SuperQuentin/TheMagicKeys/pictures/pedals.jpg

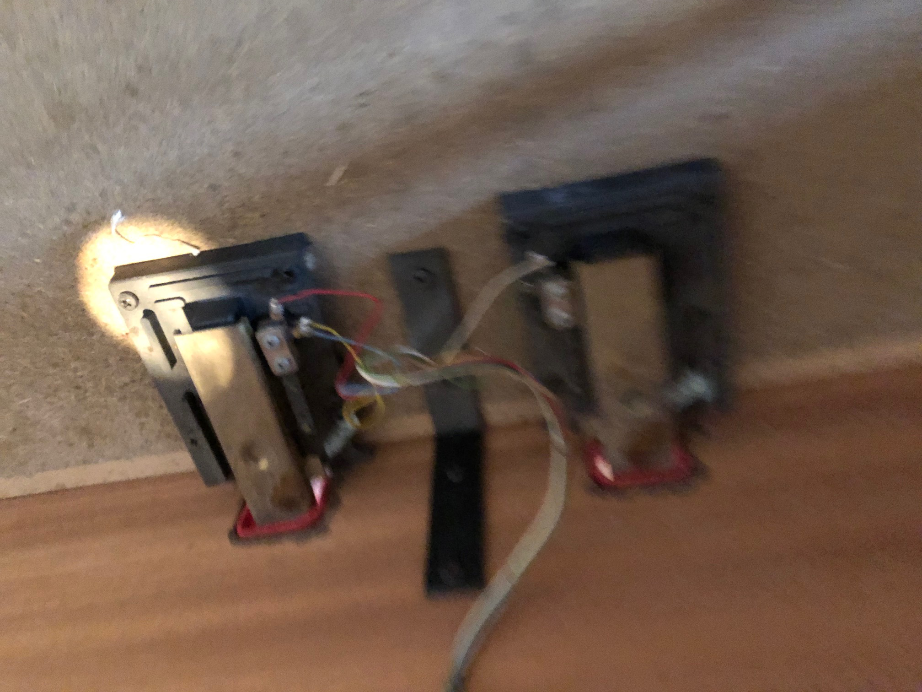
pictures/pedals.jpg
