SuperQuentin/TheMagicKeys/pictures/audio_amplifier_board.jpg

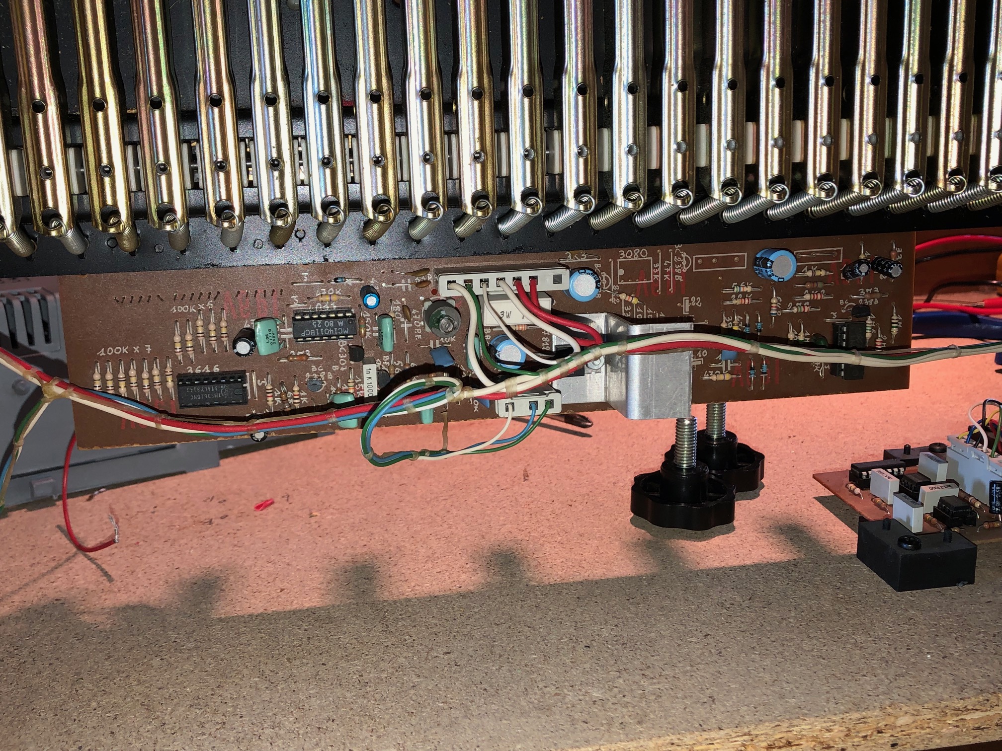
pictures/audio_amplifier_board.jpg
