SuperQuentin/TheMagicKeys/daisy_seed/key_controlled_ocillators/README.md

# key_controlled_ocillators

## Author

<!-- Insert Your Name Here -->

## Description

<!-- Describe your example here -->
