SuperQuentin/TheMagicKeys/pictures/buttons_under_keyboard_1.jpg

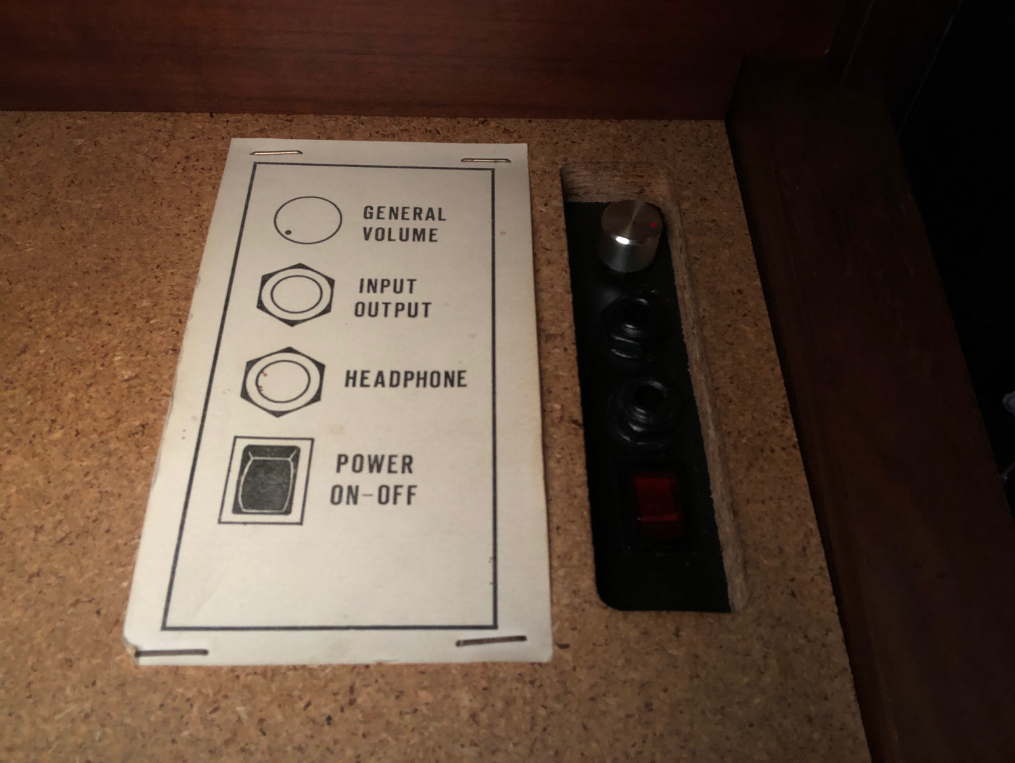
pictures/buttons_under_keyboard_1.jpg
