SuperQuentin/TheMagicKeys/pictures/buttons_under_keyboard_2.jpg

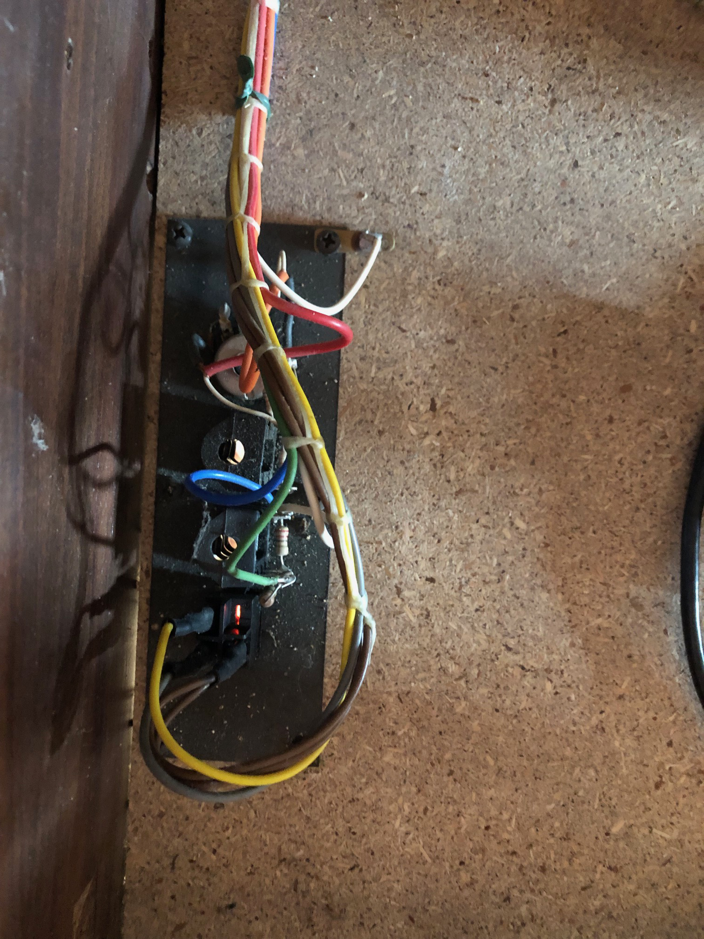
pictures/buttons_under_keyboard_2.jpg
