SuperQuentin/TheMagicKeys/pictures/load_speaker_3.jpg

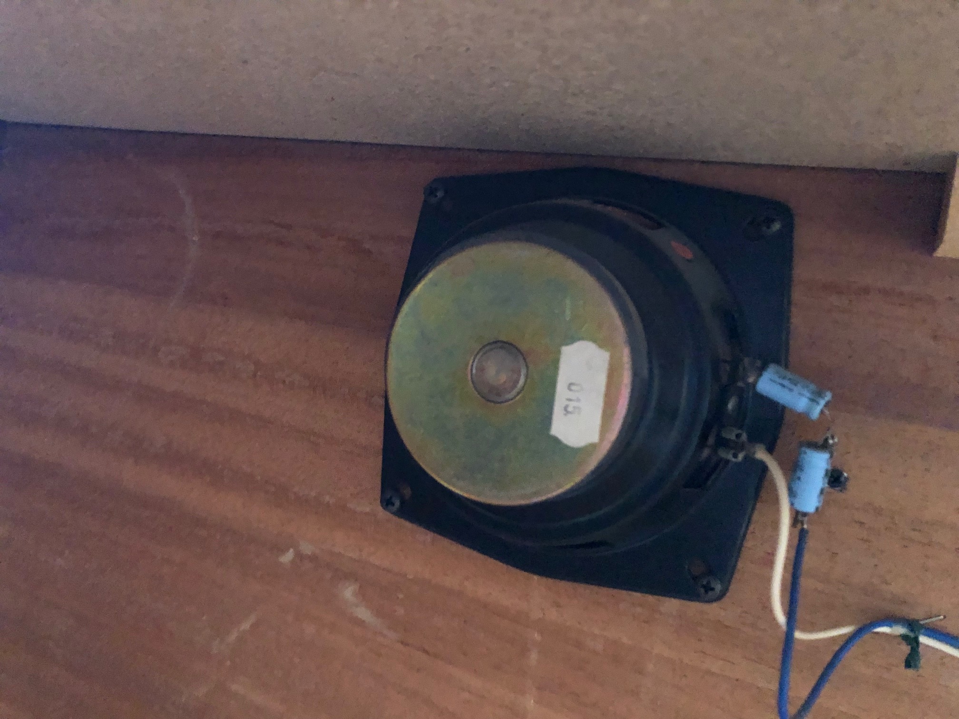
pictures/load_speaker_3.jpg
