SuperQuentin/TheMagicKeys/pictures/load_speakers_1_and_2.jpg

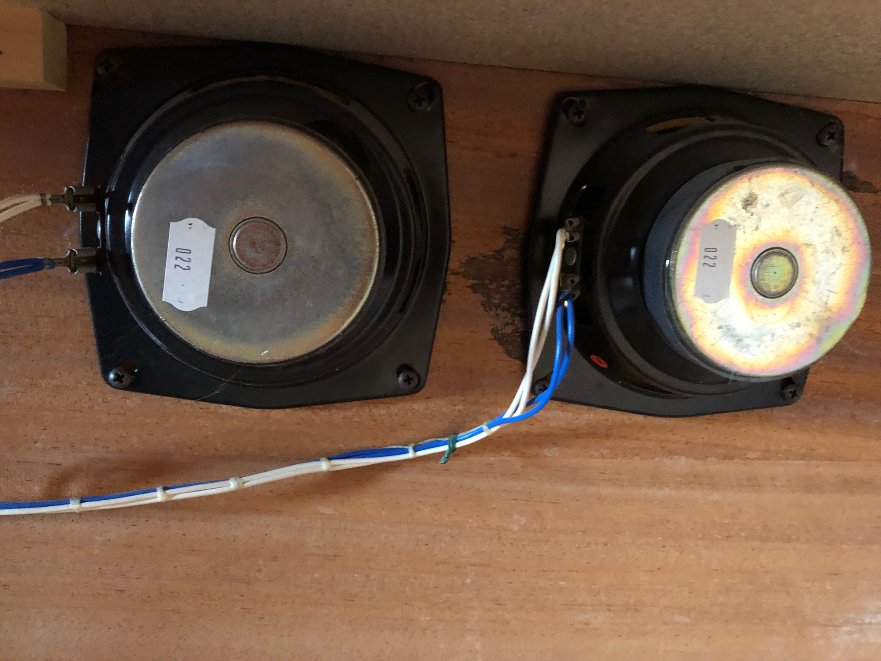
pictures/load_speakers_1_and_2.jpg
