SuperQuentin/TheMagicKeys/pictures/one_satellite_board_removed.jpg

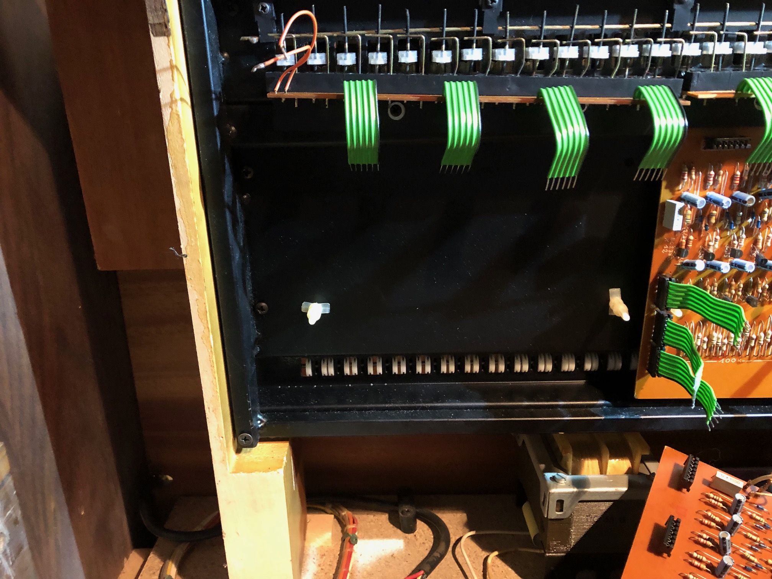
pictures/one_satellite_board_removed.jpg
