SuperQuentin/TheMagicKeys/pictures/power_supply_board.jpg

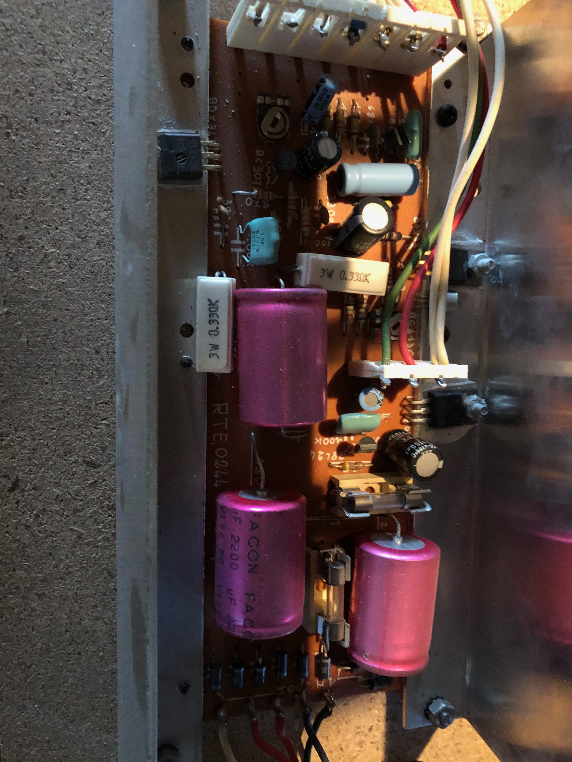
pictures/power_supply_board.jpg
