SuperQuentin/TheMagicKeys/pictures/transformer.jpg

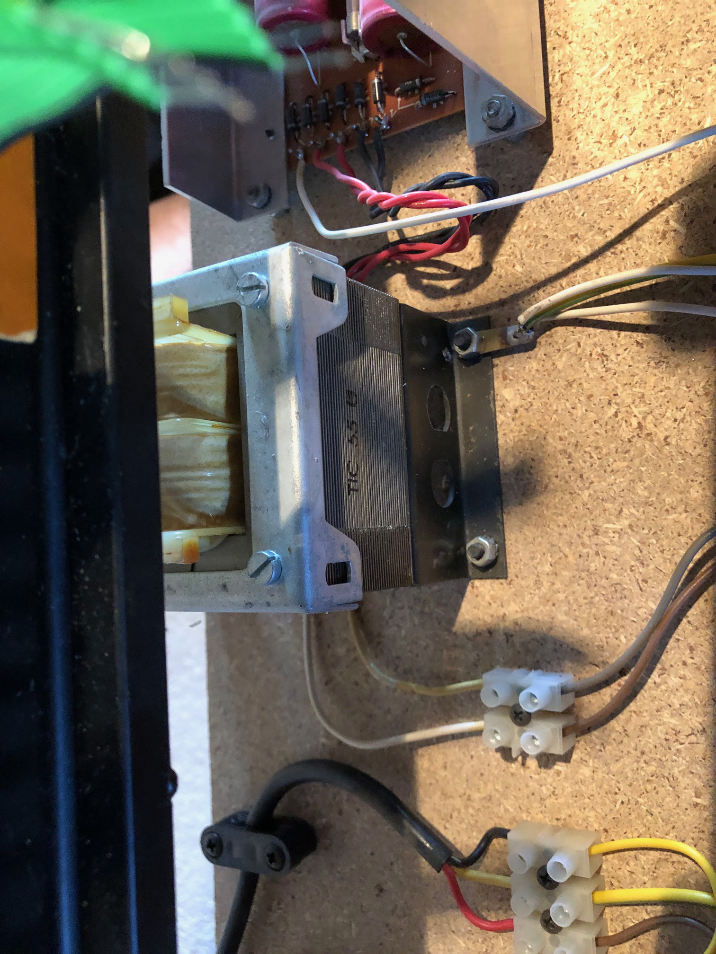
pictures/transformer.jpg
