SuperQuentin/TheMagicKeys/doc/main_board_bom.xlsx

Pos | Description | Number | Detailed description | Status
1 | Arduino nano every | 1 |  | Bought
2 | Electrosmith daisy seed | 1 |  | Ordered
3 | Voltage regulator 5V | 1 | IC REG LINEAR 5V 500MA TO220AB DigiKey Part Number 497-2957-5-ND | In cart
4 | Header connector femele 15 pins for arduino | 2 | CONN HDR 15POS 0.1 TIN PCB DigiKey Part Number: S7013-ND | In cart
5 | Header connector female 20 pins for daisy seed | 2 | CONN HDR 20POS 0.1 TIN PCB DigiKey Part Number S7018-ND | In cart
6 | Connector jack stereo audio out female (+ 1 in optional) | 2 | AUDIO JACK, 3.5MM, THROUGH HOLE, DigiKey Part Number 2223-SJ3-35083C-TRCT-ND - Cut Tape (CT) | In cart
7 | Connector 24 pins female from satellite boards | 2 | CONN HEADER VERT 24POS 2.54MM DigiKey Part Number 2057-BHR-24-VUA-ND | In cart
8 | Male connector switch mode 2 pins + VCC out 1 pin | 1 | CONN HEADER VERT 16POS 2.54MM DigiKey Part Number 2057-PH1-16-UA-ND | In cart
9 | Female connector switch mode 2 pins + VCC out 1 pin | 1 | CONN RCPT 32POS 0.1 TIN PCB DigiKey Part Number SAM1122-32-ND | In cart
10 | Level shifter | 1 | IC TRANSLTR UNIDIRECTIONAL 16DIP DigiKey Part Number 296-3505-5-ND | In cart
11 | Socket DIL 16 pins | 1 | IC SOCKET, DIP, 16P 2.54MM PITCH DigiKey Part Number 2057-ICS-316-T-ND | In cart
12 | Connector power in | 1 | DC POWER JACK,2.5MM;PCB MOUNT DigiKey Part Number 1939-G-1005B-ND | In cart
