SuperQuentin/TheMagicKeys/doc/satellite_board_bom.xlsx

Pos | Description | Number | Detailed description | Status
1 | Multiplexer 8 channels (U1 + U2) | 2 | CD74HCT251E Digikey ref 296-2106-5-ND | In cart
2 | 8 resistors 4.7 KOhm (R1) | 1 | RES ARRAY 8 RES 4.7K OHM 16DIP DigiKey Part Number 4116R-1-472LF-ND | In cart
3 | 8 resistors 20 KOhm (R2) | 1 | RES ARRAY 8 RES 20K OHM 16DIP DigiKey Part Number 4116R-1-203LF-ND | In cart
4 | 16 pins DIL Socket | 4 | IC SOCKET, DIP, 16P 2.54MM PITCH DigiKey Ref 2057-ICS-316-T-ND | In cart
5 | capacitors 1 nF (C1 + C2) | 2 | CAP FILM 1000PF 10% 63VDC RADIAL DigiKey Ref 495-2456-1-ND - Cut Tape (CT) | In cart
6 | 2 pin male header (J1) | 1 | CONN HEADER VERT 16POS 2.54MM DigiKey Part Number 2057-PH1-16-UA-ND | In cart
7 | 2 pin female header (For J1) | 1 | CONN RCPT 32POS 0.1 TIN PCB DigiKey Part Number SAM1122-32-ND | In cart
8 | 6 pins connector from old board (J2 + J3). | 2
9 | Flat ribbon male connector 24 pins (J4 + J5) | 2 | CONN HEADER VERT 24POS 2.54MM DigiKey Part Number: 2057-BHR-24-VUA-ND | In cart
10 | Flat ribbon female connector 24 pins (for J4 + J5) | 2 | SOCKET FLAT CABLE IDC 24P 2.54MM DigiKey Part Number: 2057-FCS-24-SG-ND | In cart
11 | 2 x 2 male pin headers (JP1 + JP2 + JP3) | 3 | CONN HEADER VERT 4POS 2.54MM DigiKey Part Number: 609-5699-ND | In cart
12 | 2 x 12 male pin headers (JP3 + JP4) | 2 | CONN HEADER VERT 24POS 2.54MM DigiKey Part Number: WM50012-24-ND | In cart
13 | Jumpers (for JP1 + JP2 + JP3 + JP4 + JP5) | 5 | CONN JUMPER SHORTING .100" GOLD DigiKey Part Number: S9337-ND | In cart
14 | Flat cable 24 pins | 1 | CBL RIBN 24COND FLAT 0.05 GRAY DigiKey Part Number: 19-3365/24100-DS-ND | In cart
15 | Board spacer | 4 |  | Bought
16 | Screw | 4 |  | Bought
17 | Board 150 x 176 to fix 2 satellite boards | 0.5 |  | Bought
