SuperQuentin/TheMagicKeys/doc/satellite_board_order_digikey.xlsx

Index | Quantity | Part Number | Manufacturer Part Number | Description | Customer Reference | Available | Backorder | Unit Price | Extended Price CHF
1 | 30 | 296-2106-5-ND | CD74HCT251E | IC MULTIPLEXER 1 X 8:1 16DIP |  | 30 | 0 | 0.3444 | 10,33 Fr.
2 | 15 | 4116R-1-102LF-ND | 4116R-1-102LF | RES ARRAY 8 RES 1K OHM 16DIP |  | 15 | 0 | 1.703 | 25,55 Fr.
3 | 15 | 4116R-1-472LF-ND | 4116R-1-472LF | RES ARRAY 8 RES 4.7K OHM 16DIP |  | 15 | 0 | 1.598 | 23,97 Fr.
4 | 60 | 2057-ICS-316-T-ND | ICS-316-T | IC SOCKET, DIP, 16P 2.54MM PITCH |  | 60 | 0 | 0.08733 | 5,24 Fr.
5 | 22 | 495-2456-1-ND | B32529C0102K289 | CAP FILM 1000PF 10% 63VDC RADIAL |  | 22 | 0 | 0.157 | 3,45 Fr.
6 | 15 | 861400021YO2LF-ND | 861400021YO2LF | CONN HEADER VERT 2POS 2.54MM |  | 15 | 0 | 0.075 | 1,13 Fr.
7 | 15 | 1212-1179-ND | 801-87-002-10-001101 | CONN SOCKET 2POS 0.1 GOLD PCB |  | 15 | 0 | 0.229 | 3,44 Fr.
8 | 30 | 2057-BHR-24-VUA-ND | BHR-24-VUA | CONN HEADER VERT 24POS 2.54MM |  | 30 | 0 | 0.301 | 9,03 Fr.
9 | 30 | 2057-FCS-24-SG-ND | FCS-24-SG | SOCKET FLAT CABLE IDC 24P 2.54MM |  | 30 | 0 | 0.4816 | 14,45 Fr.
10 | 45 | 609-5699-ND | 77313-118-04LF | CONN HEADER VERT 4POS 2.54MM |  | 45 | 0 | 0.168 | 7,56 Fr.
11 | 30 | WM50012-24-ND | 0010897242 | CONN HEADER VERT 24POS 2.54MM |  | 30 | 0 | 0.215 | 6,45 Fr.
12 | 100 | S9337-ND | QPC02SXGN-RC | CONN JUMPER SHORTING .100" GOLD |  | 100 | 0 | 0.0259 | 2,59 Fr.
13 | 7 | 19-3365/24100-DS-ND | 3365/24 100 | CBL RIBN 24COND FLAT 0.05 GRAY |  | 7 | 0 | 1.02143 | 7,15 Fr.
