SuperQuentin/TheMagicKeys/hardware/kicad_libraries/4116R_1_102LF/BO_4116R.step

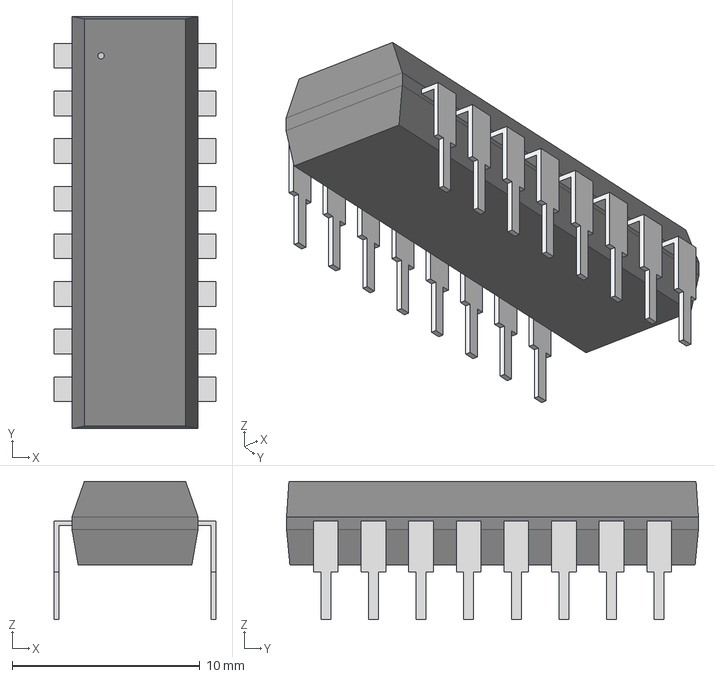
[picture p10: CAD file, 2025-09-13]
hardware/kicad_libraries/4116R_1_102LF/BO_4116R.step
8.64 x 22.0 x 7.37 mm
