SuperQuentin/TheMagicKeys/hardware/kicad_libraries/61400416021/Download_STP_61400416021_rev1.stp

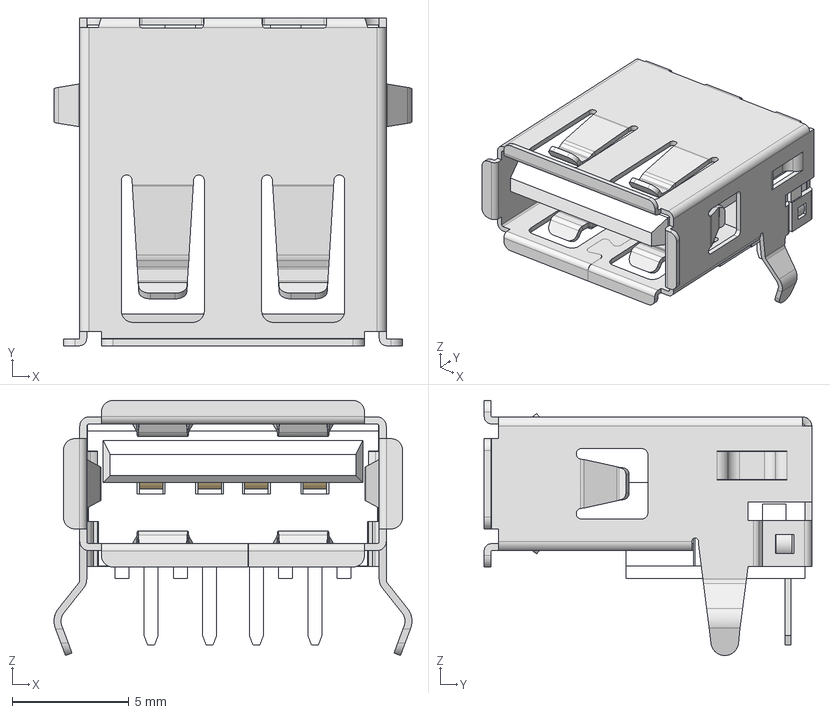
[picture p11: CAD file, 2025-09-13]
hardware/kicad_libraries/61400416021/Download_STP_61400416021_rev1.stp
15.3 x 14.0 x 10.9 mm
61400416021_Insulator
61400416021_Contact Plating x 4
61400416021_Shielding
