SuperQuentin/TheMagicKeys/hardware/kicad_libraries/800USP8P1A1M2RE/800USP8P1A1M2RE.STEP

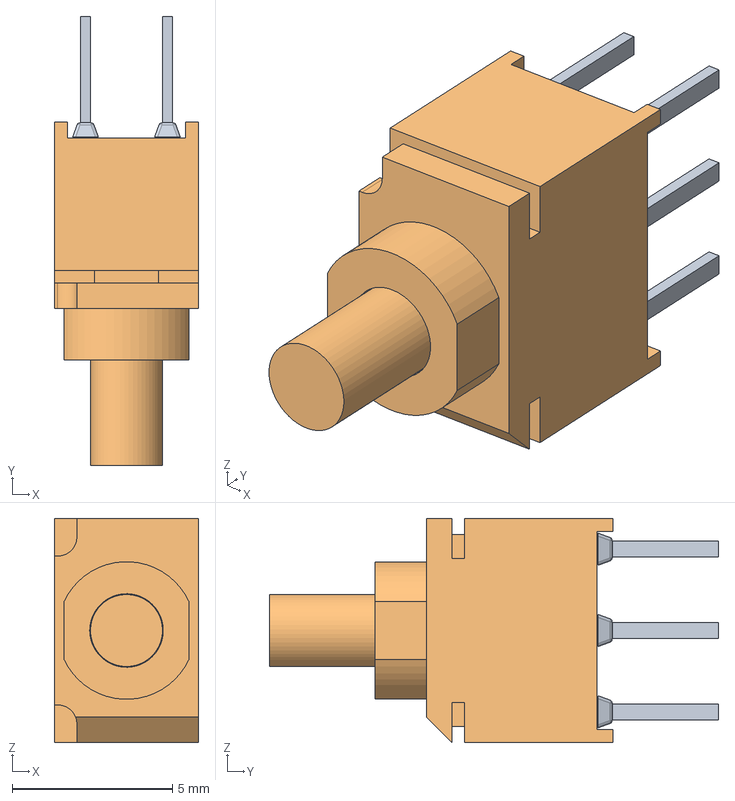
[picture p12: CAD file, 2025-09-13]
hardware/kicad_libraries/800USP8P1A1M2RE/800USP8P1A1M2RE.STEP
4.50 x 14.0 x 7.00 mm
