SuperQuentin/TheMagicKeys/hardware/kicad_libraries/CD74HCT251E/CD74HCT251E.STEP

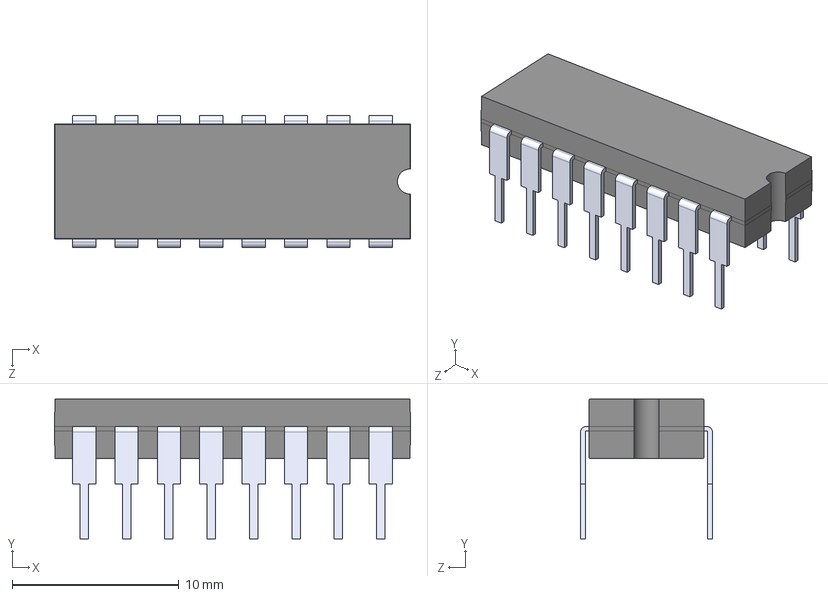
[picture p13: CAD file, 2025-09-13]
hardware/kicad_libraries/CD74HCT251E/CD74HCT251E.STEP
21.3 x 8.38 x 7.90 mm
