SuperQuentin/TheMagicKeys/hardware/kicad_libraries/DM3D_SF/DM3D-SF.step

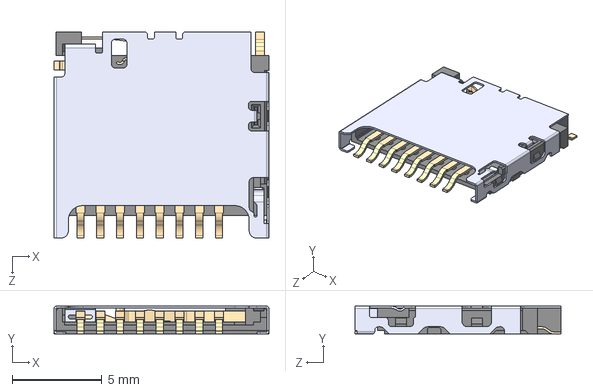
[picture p14: CAD file, 2025-09-13]
hardware/kicad_libraries/DM3D_SF/DM3D-SF.step
12.0 x 1.55 x 11.5 mm
