SuperQuentin/TheMagicKeys/hardware/kicad_libraries/EG1218/EG1218.step

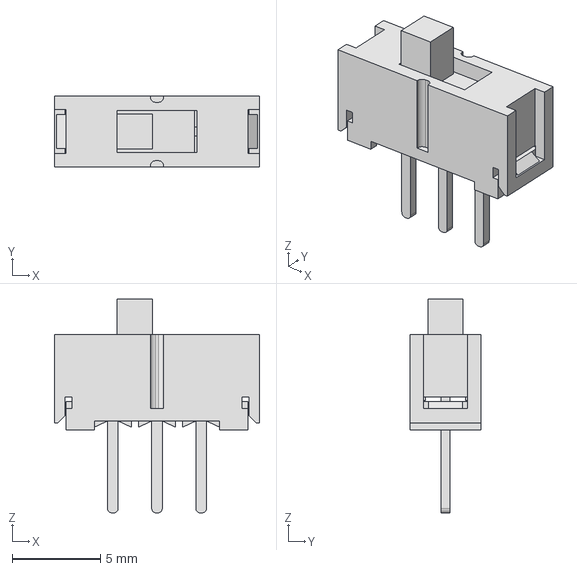
[picture p15: CAD file, 2025-09-13]
hardware/kicad_libraries/EG1218/EG1218.step
11.6 x 4.00 x 12.1 mm
