SuperQuentin/TheMagicKeys/hardware/kicad_libraries/L78M05CV/TO-220_STM.step

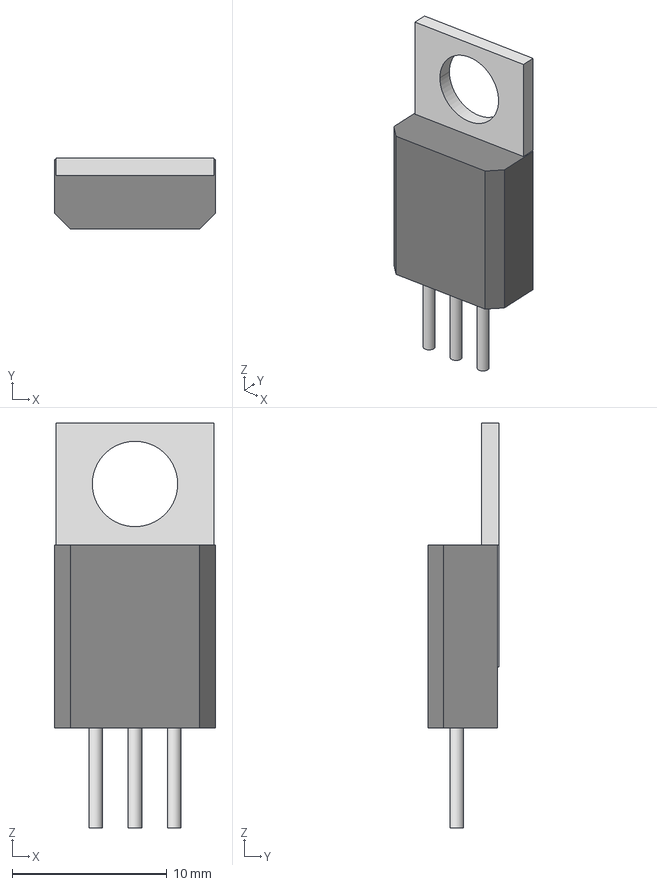
[picture p16: CAD file, 2025-09-13]
hardware/kicad_libraries/L78M05CV/TO-220_STM.step
10.4 x 4.60 x 26.2 mm
