SuperQuentin/TheMagicKeys/hardware/kicad_libraries/MCP1700_5002E_TO/MCP1702-5002E_TO.step

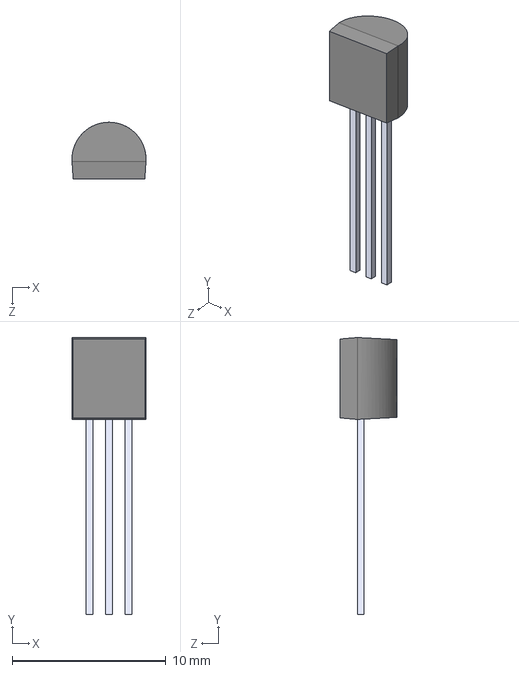
[picture p17: CAD file, 2025-09-13]
hardware/kicad_libraries/MCP1700_5002E_TO/MCP1702-5002E_TO.step
4.82 x 18.0 x 3.68 mm
