SuperQuentin/TheMagicKeys/hardware/kicad_libraries/676433910/676433910.stp

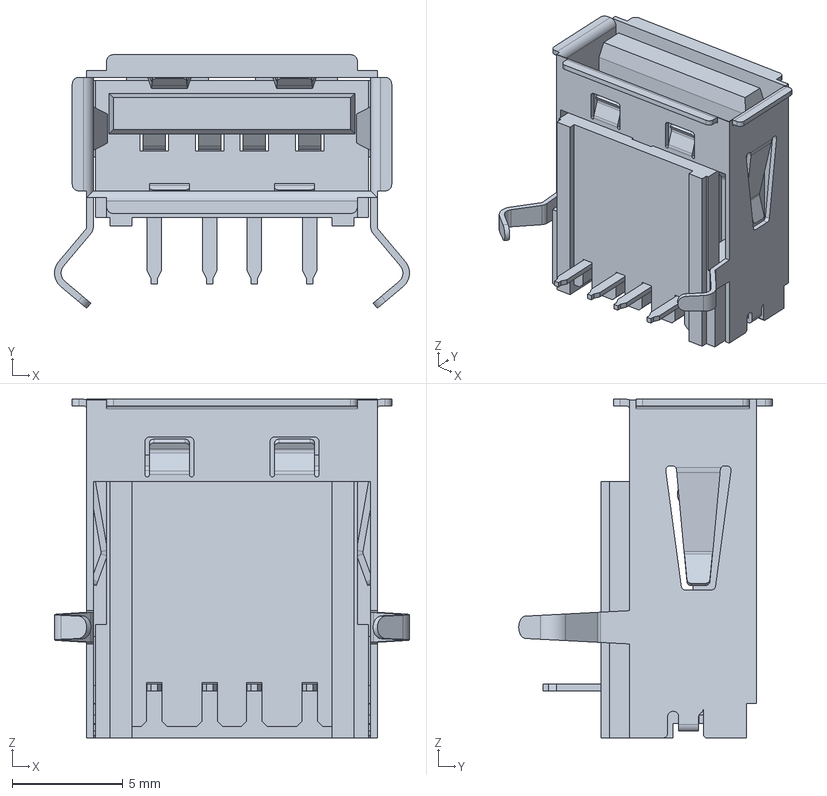
[picture p18: CAD file, 2025-09-13]
hardware/kicad_libraries/676433910/676433910.stp
16.0 x 11.4 x 15.3 mm
