SuperQuentin/TheMagicKeys/doc/how_to_solve_daisy_seed_download_issue.txt

- Run Zadig.exe (archived in daisy_seed/tools).
- Select Options/List All Devices
- Select daisy seed device
- Choose driver: WinUSB
- Replace driver
