SuperQuentin/TheMagicKeys/midi/result.txt

Start parse_midi_file
**** HEADER ****
format=1
nb_tracks=8
time_unit=120
** TRACK CHUNK **
track_len=53
v_time=0
META EVENT
meta_type=3
v_length=8
v_time=0
META EVENT
meta_type=1
v_length=12
v_time=0
META EVENT
meta_type=58
v_length=4
v_time=0
META EVENT
meta_type=59
v_length=2
v_time=0
META EVENT
meta_type=51
v_length=3
v_time=0
META EVENT
meta_type=2f
v_length=0
** TRACK CHUNK **
track_len=15156
v_time=0
META EVENT
meta_type=3
v_length=26
v_time=120
MIDI EVENT
Command=Note_On, data_byte_1=55, data_byte_2=80, channel_nb=0
v_time=1
MIDI EVENT
Command=Note_On, data_byte_1=43, data_byte_2=80, channel_nb=0
v_time=9
MIDI EVENT
Command=Note_On, data_byte_1=67, data_byte_2=80, channel_nb=0
v_time=28
MIDI EVENT
Command=Note_On, data_byte_1=43, data_byte_2=0, channel_nb=0
v_time=1
MIDI EVENT
Command=Note_On, data_byte_1=67, data_byte_2=0, channel_nb=0
v_time=2
MIDI EVENT
Command=Note_On, data_byte_1=55, data_byte_2=0, channel_nb=0
v_time=30
MIDI EVENT
Command=Note_On, data_byte_1=55, data_byte_2=80, channel_nb=0
v_time=9
MIDI EVENT
Command=Note_On, data_byte_1=43, data_byte_2=80, channel_nb=0
v_time=1
MIDI EVENT
Command=Note_On, data_byte_1=67, data_byte_2=80, channel_nb=0
v_time=124
MIDI EVENT
Command=Note_On, data_byte_1=43, data_byte_2=0, channel_nb=0
v_time=5
MIDI EVENT
Command=Note_On, data_byte_1=67, data_byte_2=0, channel_nb=0
v_time=0
MIDI EVENT
Command=Note_On, data_byte_1=55, data_byte_2=0, channel_nb=0
v_time=1
MIDI EVENT
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
v_time=18
MIDI EVENT
Command=Note_On, data_byte_1=46, data_byte_2=80, channel_nb=0
v_time=0
MIDI EVENT
Command=Note_On, data_byte_1=58, data_byte_2=80, channel_nb=0
v_time=10
MIDI EVENT
Command=Note_On, data_byte_1=60, data_byte_2=0, channel_nb=0
v_time=1
MIDI EVENT
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
