SuperQuentin/TheMagicKeys/hardware/main_board/main_board.kicad_pcb

## KiCad design hardware/main_board/main_board.kicad_pcb (2025-09-13)

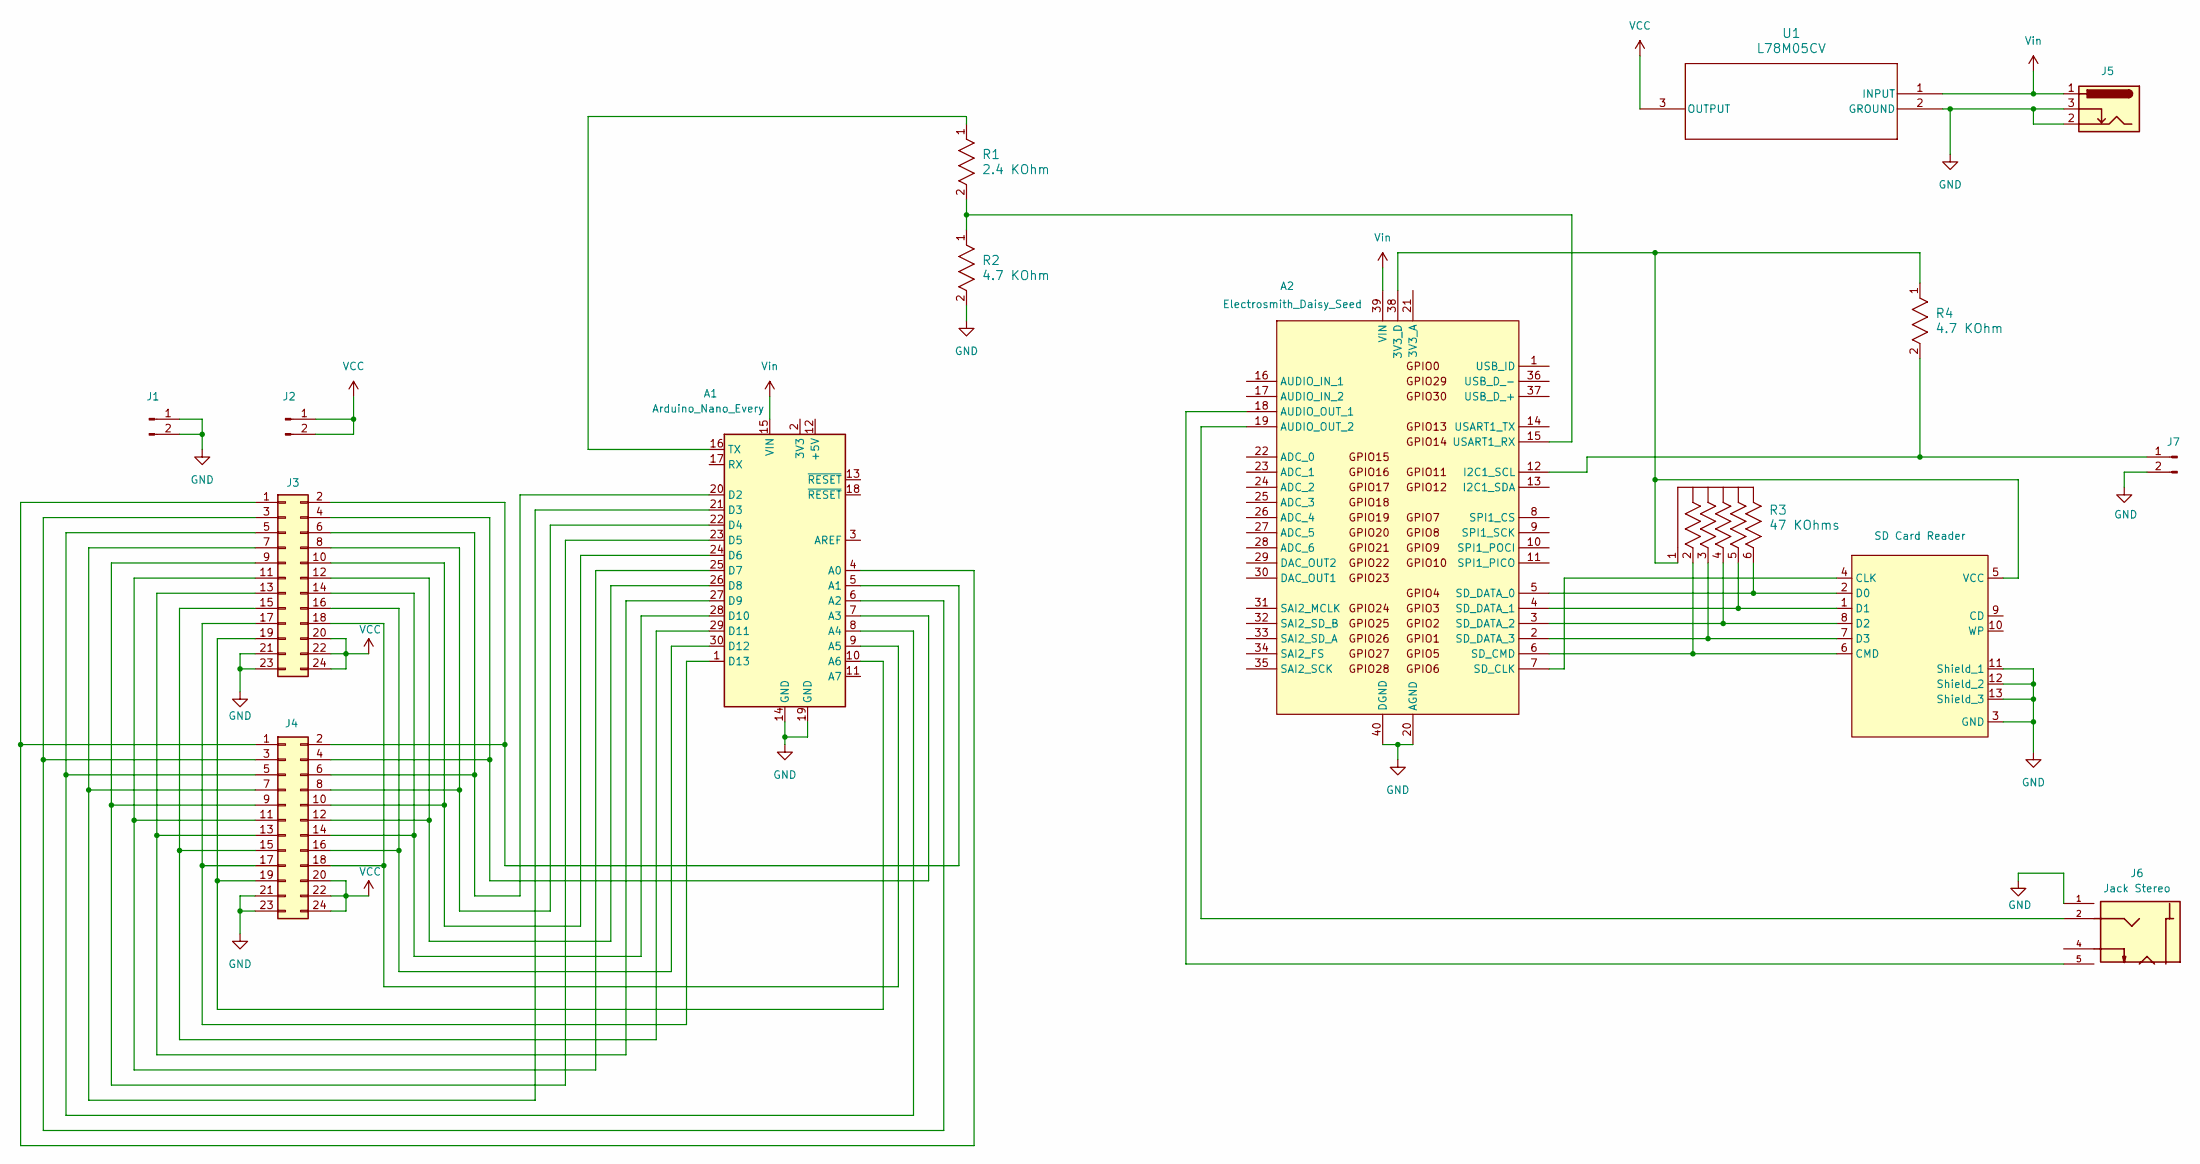
[picture p19: schematic main_board.kicad_sch, MAGIC KEYS MAIN BOARD]

Parts:
A1: Arduino_Nano_Every; Arduino_Nano
A2: Electrosmith_Daisy_Seed
J1, J2: PinHeader_2x01_P2.54mm_Vertical
J3, J4: Conn_02x12_Odd_Even; PinHeader_2x12_P2.54mm_Vertical
J5: Barrel_Jack_Switch_Pin2Ring; G-1005B
J6: Jack Stereo; SAMESKY_SJ3-35083C-TR; PARTREV 1.01
J7: Conn_01x02_Pin; PinHeader_1x02_P2.54mm_Vertical
R1: 2.4 KOhm; STA_CF14_STP
R2, R4: 4.7 KOhm; STA_CF14_STP
R3: 47 KOhms; BO_4606X
SDCardReaderBreakoutBoard1: SD Card Reader; SD_CARD_READER
U1: L78M05CV; TO-220_STM

Connections:
GND: A1.14 (GND), A1.19 (GND), A2.20 (AGND), A2.40 (DGND), J1.1, J1.2, J3.21, J3.23, J4.21, J4.23, J5.2, J5.3, J6.1, J7.2, R2.2, SDCardReaderBreakoutBoard1.3 (GND), SDCardReaderBreakoutBoard1.11 (Shield_1), SDCardReaderBreakoutBoard1.12 (Shield_2), SDCardReaderBreakoutBoard1.13 (Shield_3), U1.2 (GROUND)
unnamed: A1.4 (A0), J3.1, J4.1
unnamed: A1.5 (A1), J3.2, J4.2
unnamed: A1.6 (A2), J3.3, J4.3
unnamed: A1.7 (A3), J3.4, J4.4
unnamed: A1.8 (A4), J3.5, J4.5
unnamed: A1.9 (A5), J3.18, J4.18
unnamed: A1.10 (A6), J3.19, J4.19
unnamed: A1.20 (D2), J3.6, J4.6
unnamed: A1.21 (D3), J3.7, J4.7
unnamed: A1.22 (D4), J3.8, J4.8
unnamed: A1.23 (D5), J3.9, J4.9
unnamed: A1.24 (D6), J3.10, J4.10
unnamed: A1.25 (D7), J3.11, J4.11
unnamed: A1.26 (D8), J3.12, J4.12
unnamed: A1.27 (D9), J3.13, J4.13
unnamed: A1.28 (D10), J3.14, J4.14
unnamed: A1.29 (D11), J3.15, J4.15
unnamed: A1.30 (D12), J3.16, J4.16
unnamed: A1.1 (D13), J3.17, J4.17
unnamed: A1.16 (TX), R1.1
unnamed: A2.38 (3V3_D), R3.1, R4.1, SDCardReaderBreakoutBoard1.5 (VCC)
unnamed: A2.18 (AUDIO_OUT_1), J6.5
unnamed: A2.19 (AUDIO_OUT_2), J6.2
unnamed: A2.12 (I2C1_SCL), J7.1, R4.2
unnamed: A2.7 (SD_CLK), SDCardReaderBreakoutBoard1.4 (CLK)
unnamed: A2.6 (SD_CMD), R3.2, SDCardReaderBreakoutBoard1.6 (CMD)
unnamed: A2.5 (SD_DATA_0), R3.6, SDCardReaderBreakoutBoard1.2 (D0)
unnamed: A2.4 (SD_DATA_1), R3.5, SDCardReaderBreakoutBoard1.1 (D1)
unnamed: A2.3 (SD_DATA_2), R3.4, SDCardReaderBreakoutBoard1.8 (D2)
unnamed: A2.2 (SD_DATA_3), R3.3, SDCardReaderBreakoutBoard1.7 (D3)
unnamed: A2.15 (USART1_RX), R1.2, R2.1
VCC: J2.1, J2.2, J3.20, J3.22, J3.24, J4.20, J4.22, J4.24, U1.3 (OUTPUT)
Vin: A1.15 (VIN), A2.39 (VIN), J5.1, U1.1 (INPUT)

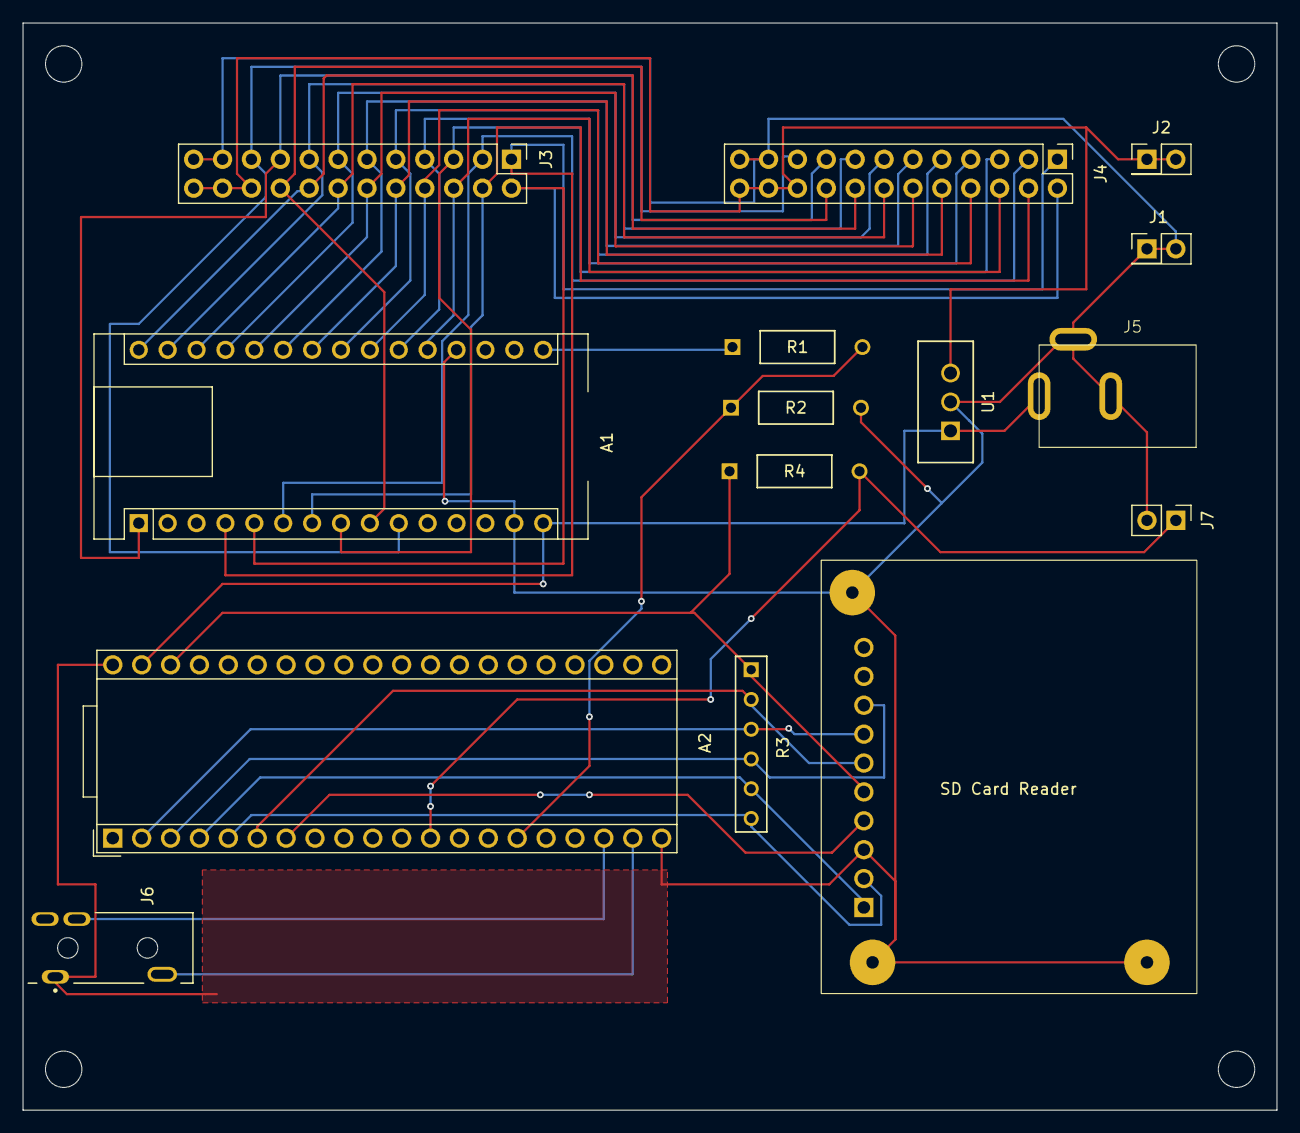
[picture p20: board main_board.kicad_pcb from above]

Board: 2 copper layers, 110.3 x 95.6 mm, 15 parts (0 on the bottom side), 34 nets.
