SuperQuentin/TheMagicKeys/hardware/piano_proto/projet_piano_proto_kicad.kicad_pcb

## KiCad design hardware/piano_proto/projet_piano_proto_kicad.kicad_pcb (2025-03-12)

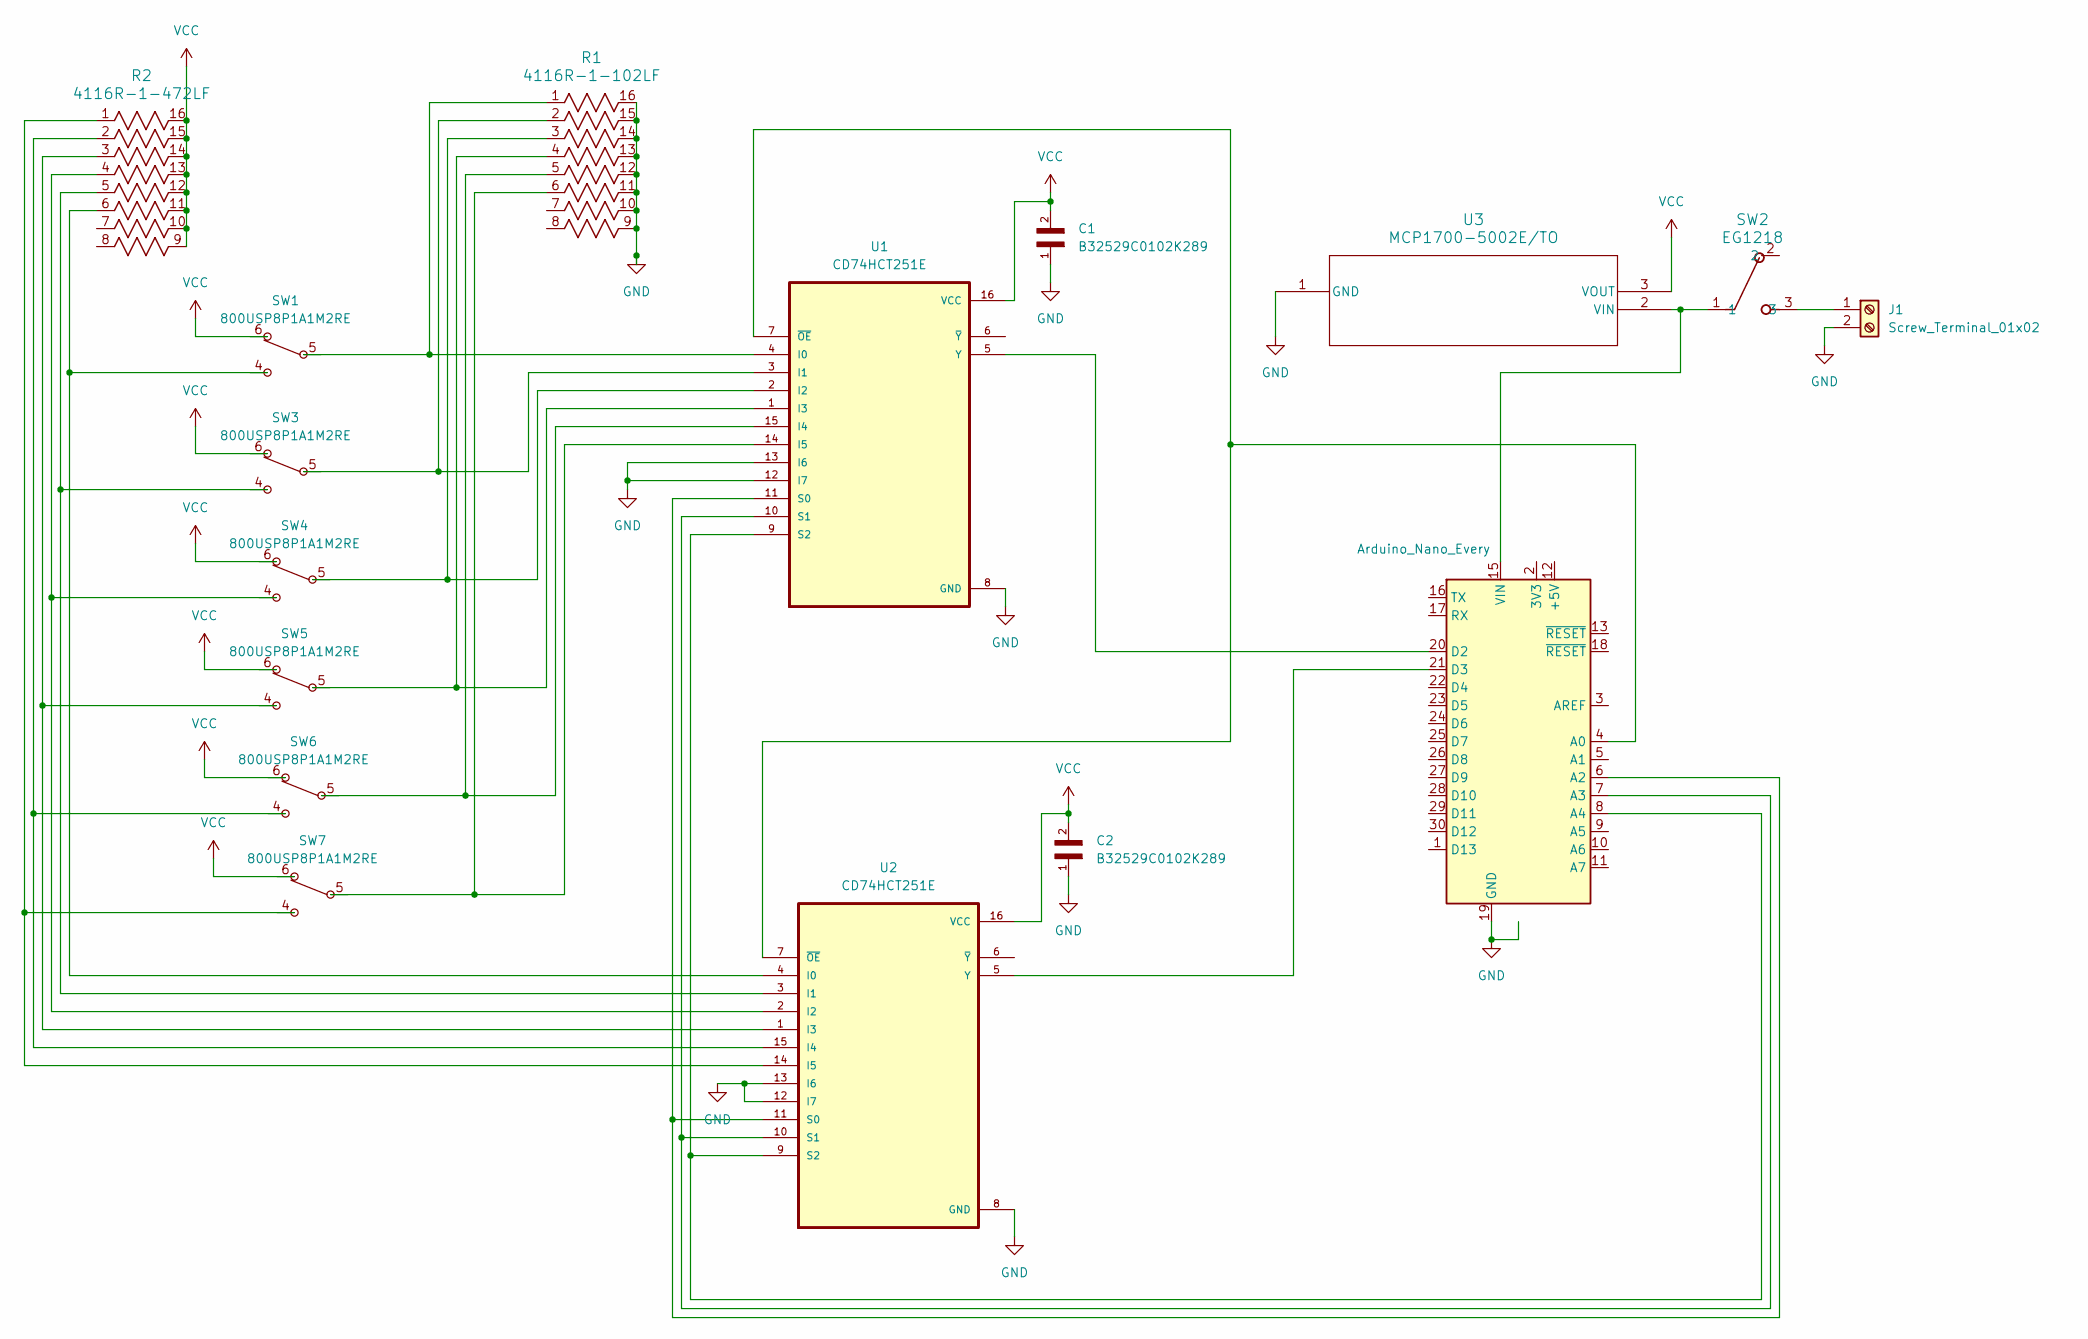
[picture p21: schematic projet_piano_proto_kicad.kicad_sch, Proto board for piano project]

Parts:
A2: Arduino_Nano_Every; Arduino_Nano
C1, C2: B32529C0102K289; CAPRR500W50L730T250H650; PARTREV 2020-06
J1: Screw_Terminal_01x02; TerminalBlock_Phoenix_MKDS-1,5-2-5.08_1x02_P5.08mm_Horizont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
R1: 4116R-1-102LF; BO_4116R
R2: 4116R-1-472LF; BO_4116R
SW1, SW3, SW4, SW5, SW6, SW7: 800USP8P1A1M2RE; Switch_Push_SPDT_800USP8P1A1M2RE
SW2: EG1218; SW_1218_EWI
U1, U2: CD74HCT251E; DIP794W45P254L1969H508Q16
U3: MCP1700-5002E/TO; TO-92_MC_MCH

Connections:
GND: A2.14 (GND), A2.19 (GND), C1.1, C2.1, J1.2, R1.9, R1.10, R1.11, R1.12, R1.13, R1.14, R1.15, R1.16, U1.8 (GND), U1.12 (I7), U1.13 (I6), U2.8 (GND), U2.12 (I7), U2.13 (I6), U3.1 (GND)
unnamed: A2.4 (A0), U1.7 (~OE), U2.7 (~OE)
unnamed: A2.6 (A2), U1.11 (S0), U2.11 (S0)
unnamed: A2.7 (A3), U1.10 (S1), U2.10 (S1)
unnamed: A2.20 (D2), U1.5 (Y)
unnamed: A2.21 (D3), U2.5 (Y)
unnamed: A2.8 (SDA/A4), U1.9 (S2), U2.9 (S2)
unnamed: A2.15 (VIN), SW2.1, U3.2 (VIN)
unnamed: J1.1, SW2.3
unnamed: R1.1, SW1.5 (COM), U1.4 (I0)
unnamed: R2.6, SW1.4 (NO), U2.4 (I0)
unnamed: R1.2, SW3.5 (COM), U1.3 (I1)
unnamed: R2.5, SW3.4 (NO), U2.3 (I1)
unnamed: R1.3, SW4.5 (COM), U1.2 (I2)
unnamed: R2.4, SW4.4 (NO), U2.2 (I2)
unnamed: R1.4, SW5.5 (COM), U1.1 (I3)
unnamed: R2.3, SW5.4 (NO), U2.1 (I3)
unnamed: R1.5, SW6.5 (COM), U1.15 (I4)
unnamed: R2.2, SW6.4 (NO), U2.15 (I4)
unnamed: R1.6, SW7.5 (COM), U1.14 (I5)
unnamed: R2.1, SW7.4 (NO), U2.14 (I5)
VCC: C1.2, C2.2, R2.9, R2.10, R2.11, R2.12, R2.13, R2.14, R2.15, R2.16, SW1.6 (NC), SW3.6 (NC), SW4.6 (NC), SW5.6 (NC), SW6.6 (NC), SW7.6 (NC), U1.16 (VCC), U2.16 (VCC), U3.3 (VOUT)

Board: 2 copper layers, 16 parts (0 on the bottom side), 22 nets, no tracks yet.
