SuperQuentin/TheMagicKeys/hardware/satellite_board_6_keys/satellite_board_6_keys.kicad_pcb

## KiCad design hardware/satellite_board_6_keys/satellite_board_6_keys.kicad_pcb (2024-12-14)

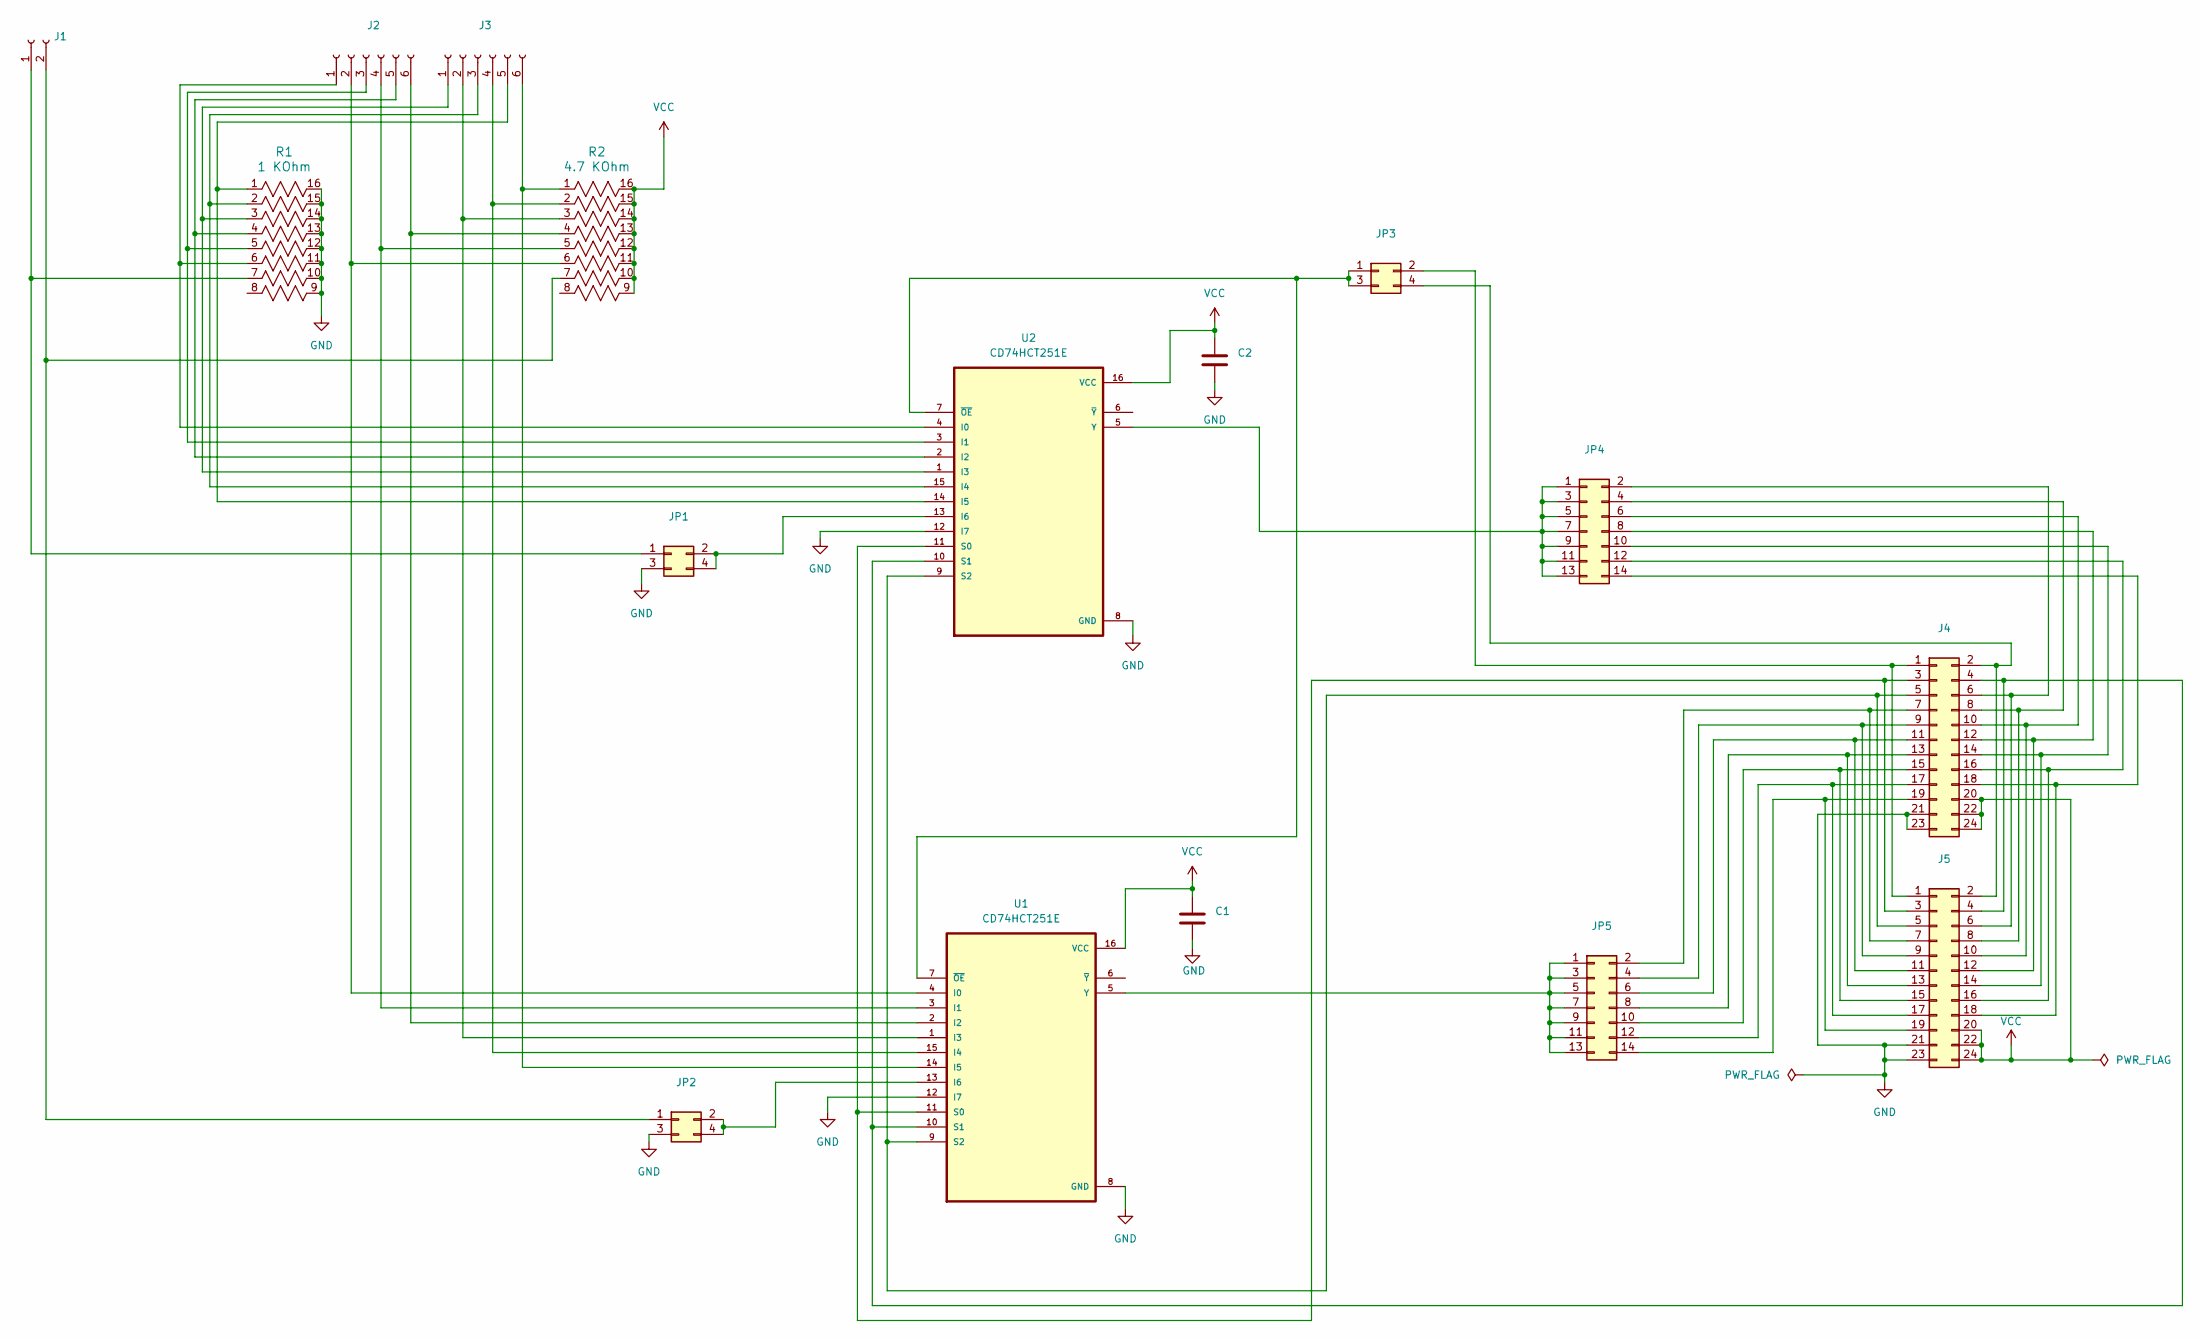
[picture p22: schematic satellite_board_6_keys.kicad_sch, Satellite board to manage 6 piano keys]

Parts:
C1, C2: C; CAPRR500W50L730T250H650
J1: Conn_01x02_Socket; PinHeader_1x02_P2.54mm_Vertical
J2, J3: Conn_01x06_Socket; PinHeader_1x06_P2.54mm_Vertical
J4, J5: Conn_02x12_Odd_Even; PinHeader_2x12_P2.54mm_Vertical
JP1, JP2, JP3: Conn_02x02_Odd_Even; PinHeader_2x02_P2.54mm_Vertical
JP4, JP5: Conn_02x07_Odd_Even; PinHeader_2x07_P2.54mm_Vertical
R1: 1 KOhm; BO_4116R
R2: 4.7 KOhm; BO_4116R
U1, U2: CD74HCT251E; DIP794W45P254L1969H508Q16

Connections:
GND: C1.2, C2.2, J4.21, J4.23, J5.21, J5.23, JP1.3, JP2.3, R1.9, R1.10, R1.11, R1.12, R1.13, R1.14, R1.15, R1.16, U1.8 (GND), U1.12 (I7), U2.8 (GND), U2.12 (I7)
unnamed: J1.1, JP1.1, R1.7
unnamed: J1.2, JP2.1, R2.7
unnamed: J2.1, R1.6, U2.4 (I0)
unnamed: J2.2, R2.6, U1.4 (I0)
unnamed: J2.3, R1.5, U2.3 (I1)
unnamed: J2.4, R2.5, U1.3 (I1)
unnamed: J2.5, R1.4, U2.2 (I2)
unnamed: J2.6, R2.4, U1.2 (I2)
unnamed: J3.1, R1.3, U2.1 (I3)
unnamed: J3.2, R2.3, U1.1 (I3)
unnamed: J3.3, R1.2, U2.15 (I4)
unnamed: J3.4, R2.2, U1.15 (I4)
unnamed: J3.5, R1.1, U2.14 (I5)
unnamed: J3.6, R2.1, U1.14 (I5)
unnamed: J4.1, J5.1, JP3.2
unnamed: J4.2, J5.2, JP3.4
unnamed: J4.3, J5.3, U1.11 (S0), U2.11 (S0)
unnamed: J4.4, J5.4, U1.10 (S1), U2.10 (S1)
unnamed: J4.5, J5.5, U1.9 (S2), U2.9 (S2)
unnamed: J4.6, J5.6, JP4.2
unnamed: J4.7, J5.7, JP5.2
unnamed: J4.8, J5.8, JP4.4
unnamed: J4.9, J5.9, JP5.4
unnamed: J4.10, J5.10, JP4.6
unnamed: J4.11, J5.11, JP5.6
unnamed: J4.12, J5.12, JP4.8
unnamed: J4.13, J5.13, JP5.8
unnamed: J4.14, J5.14, JP4.10
unnamed: J4.15, J5.15, JP5.10
unnamed: J4.16, J5.16, JP4.12
unnamed: J4.17, J5.17, JP5.12
unnamed: J4.18, J5.18, JP4.14
unnamed: J4.19, J5.19, JP5.14
unnamed: JP1.2, JP1.4, U2.13 (I6)
unnamed: JP2.2, JP2.4, U1.13 (I6)
unnamed: JP3.1, JP3.3, U1.7 (~OE), U2.7 (~OE)
unnamed: JP4.1, JP4.3, JP4.5, JP4.7, JP4.9, JP4.11, JP4.13, U2.5 (Y)
unnamed: JP5.1, JP5.3, JP5.5, JP5.7, JP5.9, JP5.11, JP5.13, U1.5 (Y)
VCC: C1.1, C2.1, J4.20, J4.22, J4.24, J5.20, J5.22, J5.24, R2.9, R2.10, R2.11, R2.12, R2.13, R2.14, R2.15, R2.16, U1.16 (VCC), U2.16 (VCC)

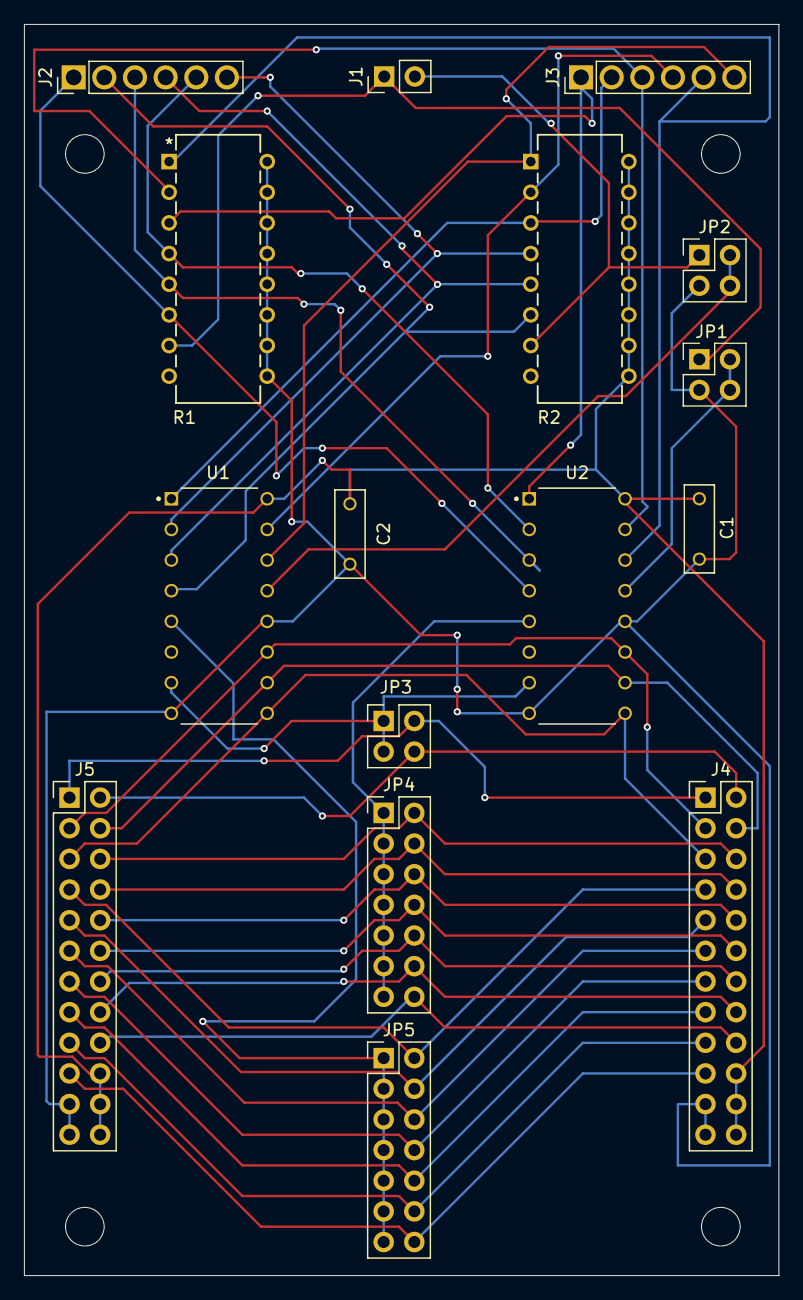
[picture p23: board satellite_board_6_keys.kicad_pcb from above]

Board: 2 copper layers, 62.5 x 103.7 mm, 16 parts (0 on the bottom side), 40 nets.
