SuperQuentin/TheMagicKeys/(commit log)

2024-11-12 First version after proto first tests
    [projet_piano_proto_kicad.kicad_pcb, projet_piano_proto_kicad.kicad_sch]
2024-11-13 Issue corrected: Switch 4 was not detected. Switch 2 was detected twice.
    [read_state_and_log.ino]
2024-12-01 Add some measurements on real keys (logical analyzer)
    [projet_piano_proto_kicad.kicad_pcb, projet_piano_proto_kicad.kicad_sch]
2024-12-10 Add a first version of a satellite board for 6 keys. Not routed yet.
    [satellite_board_6_keys.kicad_pcb, satellite_board_6_keys.kicad_sch]
2024-12-14 First routing of the satellite board
    [satellite_board_6_keys.kicad_pcb]
2024-12-14 PCB order sent to manufacturer
    [satellite_board_6_keys-B_Cu.gbr, satellite_board_6_keys-B_Mask.gbr, satellite_board_6_keys-B_Paste.gbr, satellite_board_6_keys-B_Silkscreen.gbr, satellite_board_6_keys-Edge_Cuts.gbr, satellite_board_6_keys-F_Cu.gbr, satellite_board_6_keys-F_Mask.gbr, satellite_board_6_keys-F_Paste.gbr]
2024-12-24 Start the main board design.
    [main_board_bom.xlsx, satellite_board_bom.xlsx, satellite_board_order_digikey.xlsx]
2024-12-24 [Main board] First complete schematic
    [main_board.kicad_pcb, main_board.kicad_sch, main_board_bom.xlsx]
2025-01-05 Improve robustness of prototype with daisy seed
    [main_board.kicad_pcb]
2025-03-12 First test passed with main boards and all satellite boards connected
    [main_board.kicad_pcb, main_board.kicad_sch, projet_piano_proto_kicad.kicad_pcb, projet_piano_proto_kicad.kicad_sch, satellite_board_6_keys.kicad_sch]
2025-03-12 Add main arduino program managing the 98 keys
2025-03-13 [Daisy Seed][key_controlled_oscillators]Instatntiate 35 oscillators. More is not possible.
    [key_controlled_ocillators.cpp]
2025-05-21 [Arduino]Add a program that plays the range with the daisy seed. [Daisy seed]Add a program that play the notes received from the Arduino
2025-05-21 [Daisy Seed]Now takes into account the key velocity to compute the note volume.
2025-08-02 Modifications after tests on the real piano. Remap the keys correctly (7th key not connected on Satellite boards). Disable release time because otherwise same notes cannot be played again rapidly. Tu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
    [play_notes_from_arduino.cpp, play_range_with_daisy_seed.ino]
2025-09-13 Finish main board PCB
    [676433910.stp, 800USP8P1A1M2RE.STEP, BO_4116R.step, CD74HCT251E.STEP, DM3D-SF.step, Download_STP_61400416021_rev1.stp, EG1218.step, MCP1702-5002E_TO.step]
2025-09-15 Bug corrected: Don't use on board LED, it is connected to D12 + Add a program that displays the state of the 98 keys
    [display_all_keys_state.ino, main_program.ino]
2025-10-04 [Arduino]Update program used for troubleshooting.
2025-10-05 [DaisySeed]Avoid the click sound at the end of the note (when the note is played until the end).
    [play_notes_from_arduino.cpp]
2025-10-06 [Daisyseed] Issue corrected: When the note was played until the end a click sound appears when the key or the pedal was released.
    [play_notes_from_arduino.cpp]
2025-11-01 [DaisySeed][play_notes_from_arduino][Program mode management]Program selection is now functionnal if a power cycle is applied between program change.
2025-11-02 [DaisySeed][play_notes_from_arduino][Program mode management]Program selection is now functionnal without power recycle + Global variables have been renamed.
2025-11-30 Issue corrected: program index was wrong
    [main.cpp]
